grisha-gu/agentlight/docs/01-architecture.md

# 01. Architecture

## 1.1. Why a daemon

A stateless design — every hook is a short-lived process that recolours a lamp and
exits — is not enough here:

* the device has **4 independent slots**, and something has to remember which
  `session_id` lives in which slot;
* the **buttons must be read**, so something has to stay connected to the device;
* a light must **go dark when an agent dies** without sending `SessionEnd`;
* the USB device needs **a single owner** that handles hot-plug, reconnects and the
  heartbeat.

So the host side is a resident daemon, `agentlightd`, running as a LaunchAgent, plus
stateless hooks that only forward events to it.

## 1.2. Slot states

```
        SessionStart
   OFF ─────────────► WELCOME ──► IDLE (green)
    ▲                               │  ▲
    │                UserPromptSubmit│  │ Stop
    │ SessionEnd                     ▼  │ Notification(agent_completed)
    │ / watchdog                   BUSY (yellow)
    │                               │  ▲
    │          PermissionRequest    │  │ PreToolUse / PostToolUse
    │          Notification(...)    ▼  │ PermissionDenied
    └──────────────────────────── ATTN (red)
```

Four visible states plus one transient one:

| Code | Light | Meaning |
|---|---|---|
| `OFF` | dark | the slot is free, no agent |
| `WELCOME` | ~1.2 s animation | the slot has just been taken |
| `IDLE` | green | the agent is alive and waiting for your input |
| `BUSY` | yellow | the agent is thinking or running tools |
| `ATTN` | red | the agent is blocked and waiting for a decision |

## 1.3. Mapping Claude Code hooks to states

Every hook receives `session_id`, `transcript_path`, `cwd` and `hook_event_name`.
The full list of events and their fields: <https://code.claude.com/docs/en/hooks>.

| Hook | Matcher | Transition | Hook type |
|---|---|---|---|
| `SessionStart` | — | claim a slot → `WELCOME` → `IDLE` | **command** (needs the terminal's environment) |
| `UserPromptSubmit` | — | → `BUSY` | http |
| `PreToolUse` | — | → `BUSY` (keepalive) | http |
| `PostToolUse` | — | → `BUSY` (keepalive) | http |
| `PostToolUseFailure` | — | → `BUSY` | http |
| `PermissionRequest` | — | → `ATTN` | http |
| `PermissionDenied` | — | → `BUSY` | http |
| `Notification` | `permission_prompt` | → `ATTN` | http |
| `Notification` | `idle_prompt` | **ignored** (see below) | http |
| `Notification` | `agent_needs_input` | → `ATTN` | http |
| `Notification` | `elicitation_dialog`, `elicitation_url_dialog` | → `ATTN` | http |
| `Notification` | `agent_completed` | → `IDLE` | http |
| `Elicitation` | — | → `ATTN` | http |
| `Stop` | — | → `IDLE` | http |
| `StopFailure` | — | → `ATTN` (API error — a human is needed) | http |
| `SubagentStart` / `SubagentStop` | — | **no state change** (only extends the session's lifetime) | http |
| `PreCompact` / `PostCompact` | — | **no state change** | — |
| `SessionEnd` | — | release the slot → `OFF` | http |

### Why `idle_prompt` does not mean `ATTN`

`Notification(idle_prompt)` looks like "input required", but captured traffic shows
it is an **inactivity timer**: it fires exactly 60 seconds after the agent finishes
its turn.

```
17:34:19.679  Stop                        → IDLE (green)
17:35:19.695  Notification idle_prompt    exactly +60.0 s
              message: "Claude is waiting for your input"
```

It means the same thing as `Stop`: the agent is done and waiting for you. Mapping
it to `ATTN` would turn every idle agent red a minute after it answered, and red
would stop meaning "nothing happens without you".

**Rule: `ATTN` only when the agent is actually blocked on a decision** —
`PermissionRequest`, `Notification(permission_prompt)`,
`Notification(agent_needs_input)`, `Elicitation`, `StopFailure`.
`idle_prompt` does not change the state at all.

Self-healing sequences the state machine is tested against:

```
Pre(BUSY) → PermissionRequest(ATTN) → [user allows] → PostToolUse(BUSY) → Stop(IDLE)
Pre(BUSY) → PermissionRequest(ATTN) → [user denies] → PermissionDenied(BUSY) → Stop(IDLE)
Stop(IDLE) → Notification(idle_prompt, +60 s) (state does NOT change, stays IDLE)
```

### Why subagents do not turn the light yellow

Claude Code launches forked agents on its own while you are away: `away_summary`
(after ~3 minutes of inactivity), `prompt_suggestion`, `agent_summary`, and it may
compact the context while idle. If `SubagentStart`/`SubagentStop` mapped to `BUSY`,
an idle agent would turn yellow a few minutes after `Stop` and stay that way until
`busy_timeout_sec`. A real subagent runs inside a turn, when the slot is already
yellow from `UserPromptSubmit`/`PreToolUse`, so nothing is lost by ignoring them.

To debug cases like this, the daemon logs every hook (without prompts or tool
contents) to `~/.agentlight/hooks.jsonl`.

### `/clear` and `--resume`

`/clear` produces `SessionEnd(end_reason="clear")` followed by
`SessionStart(source="clear")` with a **new** `session_id`. Releasing the slot on
`SessionEnd` right away would make the light blink off and possibly move the agent
to another slot.

So on `SessionEnd` with `end_reason ∈ {clear, resume}` the slot is not released
but marked `rebinding` for 15 seconds, keyed by `(cwd, claude_pid)`. The next
`SessionStart` with the same key takes the same slot and does **not** play the
welcome animation.

## 1.4. Slot allocation

```
claim(session_id, cwd, pid):
  1. if session_id already has a slot → return it
  1a. if the claude process is a daemon spare or a parked tab → hidden "background" list
  1b. if it is a background session whose parked tab holds a slot → take that slot, no welcome
  2. if a slot is in `rebinding` with key (cwd, pid) → take it, no welcome
  3. if the config pins cwd (or a parent path) to a slot and that slot is free → take it
  4. otherwise → the lowest free index 0..slot_count-1
  5. if nothing is free → overflow queue (no light)
```

* **Background sessions** (`claude --bg`, a session sent to the background, a task
  dispatched from agent view) run under Claude Code's own daemon, in a pty that is
  not a terminal window. Their roles come from Claude Code's registry,
  `~/.claude/sessions/<pid>.json` (internal format, checked on 2.1.309–2.1.316):
  * `kind: "bg"` with a `jobId` is a background session; it gets a light like any
    other session.
  * `kind: "interactive"` with `parkedJobId` is a **parked tab**: its session was
    forked into job `parkedJobId`, and the process stays on as a viewer for agent view
    and attached sessions. Its own session gets no light; its slot passes to the
    session of that job, so the light the user associates with the tab stays put.
    `parkedJobId` does not change when the user switches sessions inside the tab, so
    what the tab shows right now is not knowable.
  * `spare: true` is the spare process the daemon pre-spawns for agent view's input
    box. It has no light until the user dispatches a task from agent view: then the
    flag disappears and the same process becomes an ordinary background session. An
    unclaimed spare has no registry file yet but already runs `SessionStart`; it is
    recognized by `--bg-spare` in its argv.

  Hidden sessions go to the `background` list (shown by `agentlight status`); their
  events are absorbed there, and the entry is dropped on `SessionEnd` or when the
  process dies. The registry is re-read on every hook and in the 5-second sweep, which
  moves sessions between slots and `background` both ways.
* **Cross-check against the public list.** The registry is an internal format and may
  change in any release, so every 30 seconds the daemon also runs `claude agents
  --json`, which the CLI documents for scripting. It lists exactly the real sessions
  (interactive, `-p`, background) and leaves out parked tabs and spares. Where both
  sources know a process and disagree, the public list wins, and the daemon logs a
  warning once (`agentlight doctor` runs the same check). The list is ignored for a
  process that started, or whose registry file changed, after the snapshot, and it
  only ever hides a process that has a registry file or `--bg-spare` in its argv.
  Without a recognizable registry, `--bg-spare` alone hides nothing, because a task
  dispatched from agent view keeps that argv. What cannot be recovered without the
  registry is the parked tab, so a forked session then takes a new slot instead of
  its tab's. `AGENTLIGHT_CLAUDE_SESSIONS=<dir>` points the host at another registry
  directory, which is how to rehearse a format change.
* **The focus button for a background session** resolves its tab at press time: a
  live `claude attach <id>` on that job, otherwise the parked tab it came from (most
  likely still showing it), otherwise a new Terminal window with `claude attach <id>`.
  A second `attach` only mirrors the session, it does not take it over.
* `release(slot)` happens on `SessionEnd`, on a liveness check (`kill(pid, 0)`
  every 5 s), or on a TTL (no events for 8 hours). The TTL only applies to sessions
  without a known PID, and time the Mac spends asleep does not count.
* **Esc** (interrupting a turn, dismissing a question or a permission prompt) sends
  no hook. The daemon tails the session transcript and treats the
  `[Request interrupted by user…]` line as → `IDLE`.
* When a slot is released, the occupied slots to its right shift left, so there are
  no gaps between lights (shifted slots do not replay the welcome animation; mute
  and `rebinding` move with the slot). The overflow session with the most recent
  event moves into the first free slot (and does get a welcome). Pins and the
  empty-slot button only affect where a session lands when it starts.
* The mapping is persisted in `~/.agentlight/state.json` (atomic write via a temp
  file + rename), so restarting the daemon keeps the assignments.

### Configuration

`~/.agentlight/config.json`:

```json
{
  "port": 48879,
  "brightness": 120,
  "slot_count": 4,
  "pins": {
    "/Users/me/projects/agentlight": 0,
    "/Users/me/work/backend": 1
  },
  "busy_timeout_sec": 900,
  "idle_pulse": false,
  "empty_slot_button_launches": "~/projects",
  "terminal_focus_order": ["tmux", "native", "new_window"],
  "menu_bar_icon": "auto"
}
```

`slot_count` is the number of lights in the app (1–16, default 4; also editable in
**Settings…**). One device shows 4 of them: the first connected device shows slots
0..3, the second 4..7, and so on ([§5.8](05-host-macos.md#58-usb-transport)). Slots
without a device are only visible in the menu bar. Lowering `slot_count` moves
sessions from the removed slots to overflow; raising it fills the new slots from
overflow.

`menu_bar_icon` is how the menu bar icon draws its lights (also in **Settings…**):
`auto` (default) puts each group of four on a dark rounded plate when the menu bar
shows black icons, `plain` never does, `plates` always does.

## 1.5. Two-level watchdog

| Level | Condition | Action |
|---|---|---|
| host → slot | no events in `BUSY` for `busy_timeout_sec` (900 s) | degrade to `IDLE` |
| host → slot | `kill(pid, 0)` fails | `release` → `OFF` |
| device → all slots | no `PING` from the host for > 3 s | turn every light off |

The last one keeps the lights honest: if the daemon crashes or the Mac goes to
sleep, the lights go dark on their own instead of showing a stale green.

## 1.6. Buttons

| Press | Slot occupied | Slot empty |
|---|---|---|
| short | focus the agent's terminal window | start a new `claude` in the directory from `empty_slot_button_launches` |

A button has exactly one action and reacts immediately — there are no long-press or
double-press gestures, so no press is delayed waiting for a second one. Muting a
slot is available as `agentlight mute <slot>`. Debouncing happens in the firmware;
the host receives a ready `!BTN <slot> press`.

## 1.7. Repository layout

```
agentlight/
├── firmware/              # RP2040 firmware, Pico SDK + TinyUSB, C
│   └── src/               # leds, anim, buttons, power, proto, transport_hid, usb_descriptors, …
├── host/                  # macOS app: Swift package
│   ├── Sources/
│   │   ├── AgentLightKit/ # slots, state machine, transports, hooks — no UI, unit-tested
│   │   ├── agentlightd/   # the daemon + menu bar UI
│   │   └── agentlight/    # CLI: install-hooks, status, doctor, …
│   ├── Tests/
│   └── scripts/           # build-app.sh (AgentLight.app), icon generator
├── hardware/pcb/          # KiCad board, generated by Python scripts; JLCPCB fab outputs
├── packaging/homebrew/    # Homebrew cask template
├── tools/
│   ├── proto_test.py      # firmware protocol test over CDC
│   ├── flash.sh           # build + flash without pressing BOOT
│   └── hook-capture/      # HTTP hook capture server + recorded samples (test fixture)
└── docs/
```
