grisha-gu/agentlight/hardware/pcb/agentlight.kicad_pcb

## KiCad design hardware/pcb/agentlight.kicad_pcb (2026-10-31)

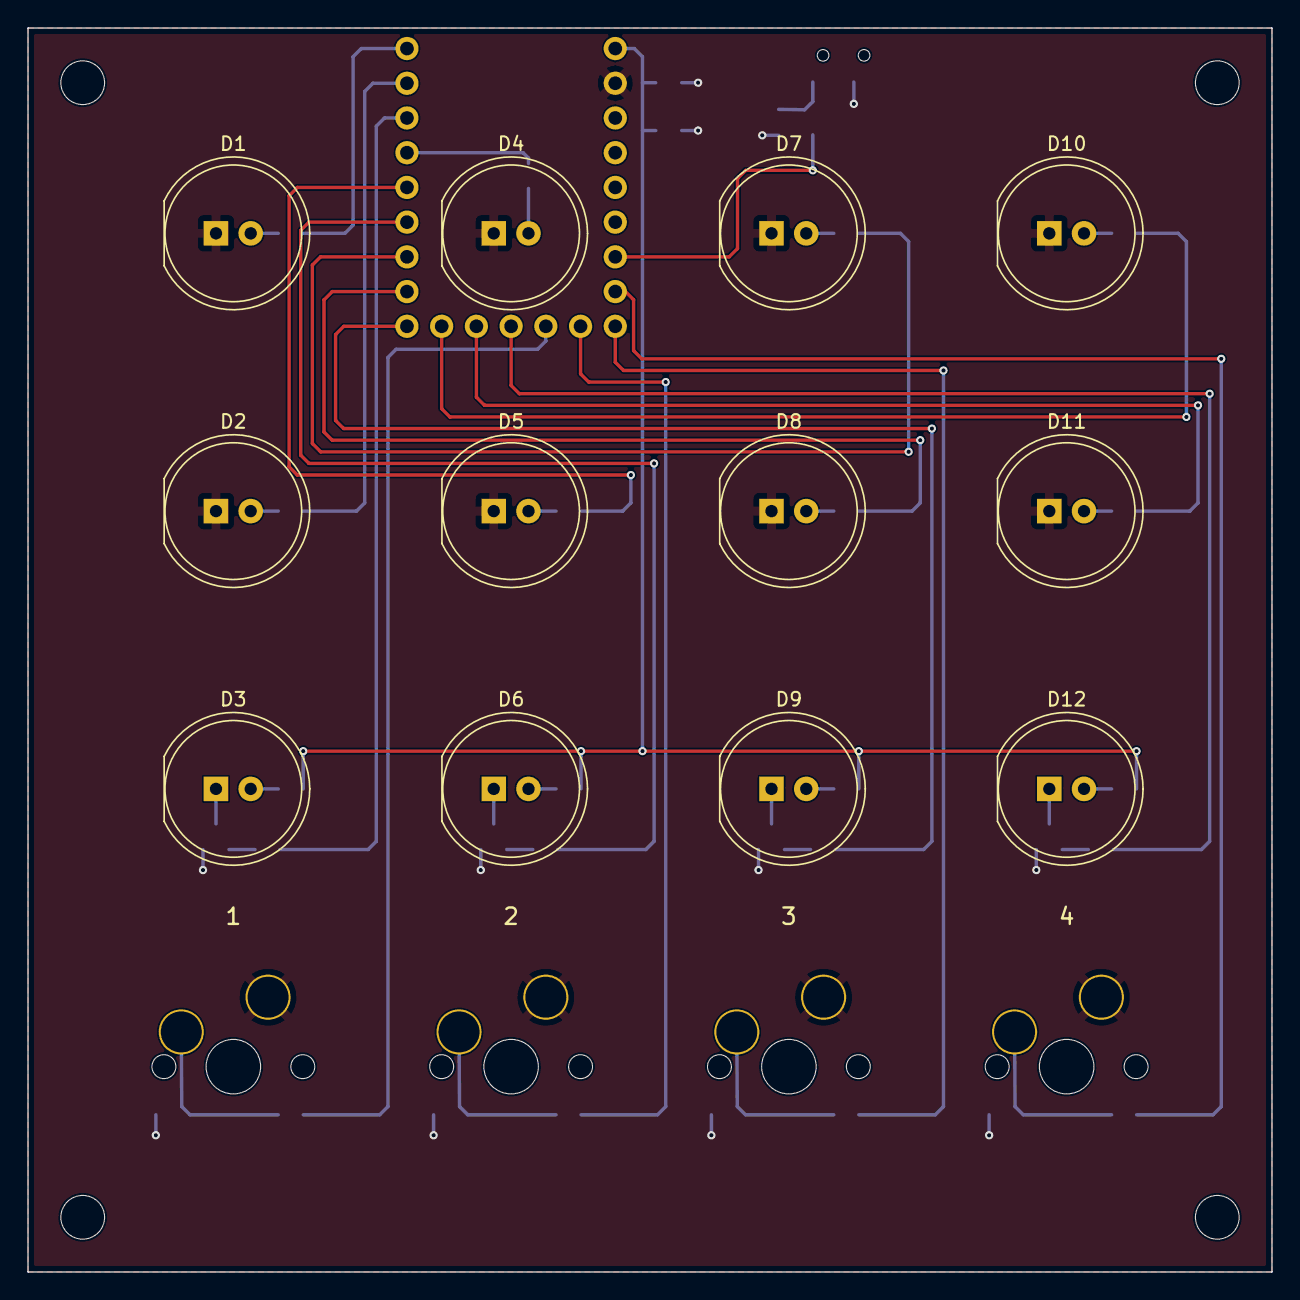
[picture p1: board agentlight.kicad_pcb from above]

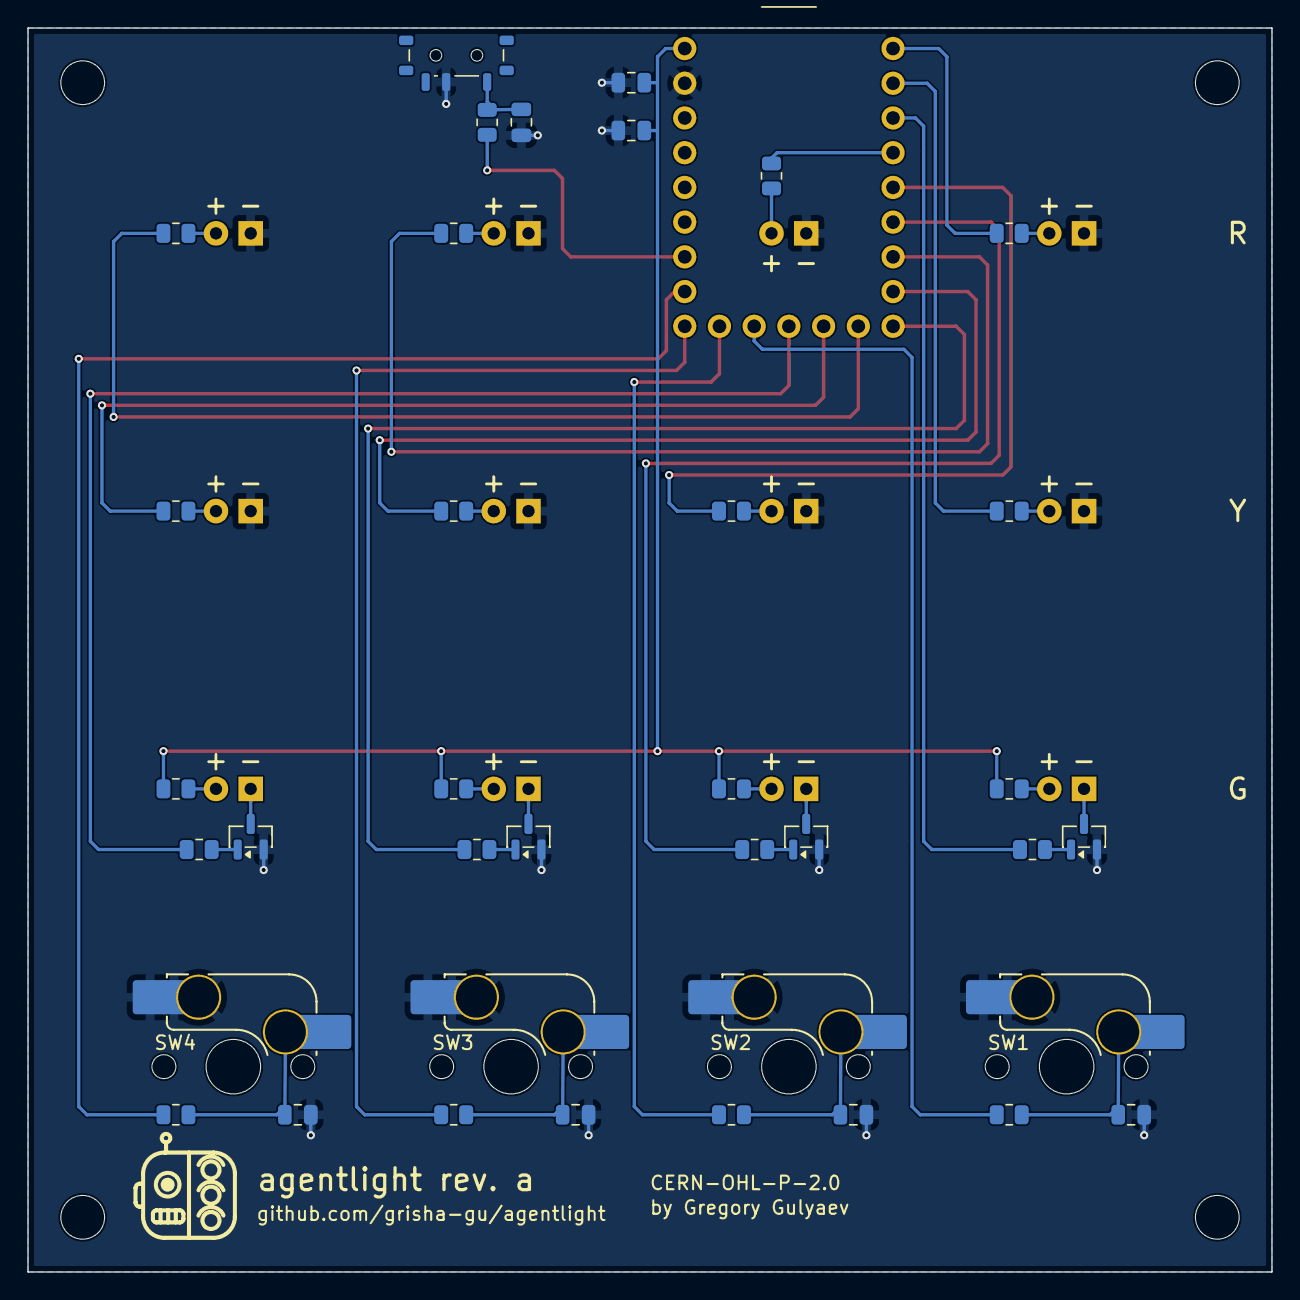
[picture p2: board agentlight.kicad_pcb from below]

Board: 2 copper layers, 91.0 x 91.0 mm, 57 parts (41 on the bottom side), 44 nets.

Parts:
C1, C2, C3, C4, C5, C7: 100n; C_0805_2012Metric
C6: 10u; C_0805_2012Metric
D1, D4, D7, D10: LED10_RED; LED_D10.0mm
D2, D5, D8, D11: LED10_YELLOW; LED_D10.0mm
D3, D6, D9, D12: LED10_GREEN; LED_D10.0mm
H1, H2, H3, H4: M3; MountingHole_3.2mm_M3
J1, J2: Socket_1x8; PinSocket_1x08_P2.54mm_Vertical
J3: Socket_1x7; PinSocket_1x07_P2.54mm_Vertical
Q1, Q2, Q3, Q4: S8050; SOT-23
R1, R2, R4, R5, R7, R8, R10, R11, R31, R32, R33, R34, R35: 220; R_0805_2012Metric
R3, R6, R9, R12: 330; R_0805_2012Metric
R21, R22, R23, R24: 1k; R_0805_2012Metric
SW1, SW2, SW3, SW4: MX_hotswap; SW_MX_HS_CPG151101S11_1u
SW5: MSK12C02; SW_SPDT_Shouhan_MSK12C02
U1: RP2040-Zero; RP2040-Zero_Outline

Connections:
+5V: C6.2, C7.2, J2.1, R3.1, R6.1, R9.1, R12.1
BTN0: C1.1, R31.2, SW1.1
BTN1: C2.1, R32.2, SW2.1
BTN2: C3.1, R33.2, SW3.1
BTN3: C4.1, R34.2, SW4.1
GND: C1.2, C2.2, C3.2, C4.2, C5.1, C6.1, C7.1, D1.1, D2.1, D4.1, D5.1, D7.1, D8.1, D10.1, D11.1, J2.2, Q1.2, Q2.2, Q3.2, Q4.2, SW1.2, SW2.2, SW3.2, SW4.2, SW5.2
GP0: J1.1, R1.1
GP1: J1.2, R2.1
GP2: J1.3, R21.1
GP3: J1.4, R4.2
GP4: J1.5, R5.1
GP5: J1.6, R22.1
GP6: J1.7, R7.1
GP7: J1.8, R8.1
GP8: J3.1, R23.1
GP9: J3.2, R10.1
GP10: J3.3, R11.1
GP11: J3.4, R24.1
GP12: J3.5, R31.1
GP13: J3.6, R32.1
GP14: J3.7, R33.1
GP15: J2.8, R34.1
GP26: J2.7, R35.1
LED0_A: D1.2, R1.2
LED1_A: D2.2, R2.2
LED2_A: D3.2, R3.2
LED2_K: D3.1, Q1.3
LED3_A: D4.2, R4.1
LED4_A: D5.2, R5.2
LED5_A: D6.2, R6.2
LED5_K: D6.1, Q2.3
LED6_A: D7.2, R7.2
LED7_A: D8.2, R8.2
LED8_A: D9.2, R9.2
LED8_K: D9.1, Q3.3
LED9_A: D10.2, R10.2
LED10_A: D11.2, R11.2
LED11_A: D12.2, R12.2
LED11_K: D12.1, Q4.3
PWR_SW: C5.2, R35.2, SW5.1
Q0_B: Q1.1, R21.2
Q1_B: Q2.1, R22.2
Q2_B: Q3.1, R23.2
Q3_B: Q4.1, R24.2
