grisha-gu/agentlight/(commit log)

2026-10-31 Initial import: host app, firmware, PCB rev. a, docs
    State as of PCB rev. a ordered from JLCPCB (2026-10-31): macOS daemon and
    CLI (host/), RP2040 firmware 0.6.0 (firmware/), board generated by
    hardware/pcb/gen_board.py, design docs (docs/).
    Licenses: code MIT, hardware CERN-OHL-P-2.0, docs CC-BY-4.0.
    [agentlight.kicad_pcb]
2026-11-02 Host 0.2.0: bundle id dev.grisha-gu.agentlight, doctor checks Automation, wake fix
    - Bundle id com.agentlight.app → dev.grisha-gu.agentlight, LaunchAgent label
    dev.grisha-gu.agentlight.daemon; install-daemon removes the legacy agent,
    build-app.sh --install migrates automatically.
    - doctor reports Automation → Terminal: the daemon asks TCC without a prompt
    (AEDeterminePermissionToAutomateTarget) and returns it in /status.
    - Sleep: after DarkWake → FullWake macOS posts no didWake, so the daemon stayed
    paused and sent nothing to the device. Also resume on screensDidWake; keep the
    earliest sleep time across consecutive willSleep.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
    [proto_test.py]
2026-11-02 Background sessions: hide windowless ones, light up forks in their owner tab
    Sessions hosted by the Claude Code daemon (claude --bg, forks sent to the
    background) run under bg-pty-host. The daemon also pre-spawns a --bg-spare
    process that fires SessionStart with no user behind it and sat on a light
    as a permanently idle agent.
    A fork is watched from the tab that started the daemon: the daemon's argv
    carries `--spawned-by {"pid":N}`. While claude process N is alive and has
    a tty, the session gets its own slot, the hook reports N's terminal (tty
    and env read via KERN_PROCARGS2), and the focus button resolves the owner
    tab at press time for sessions that started earlier.
    --bg-spare and forks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
2026-11-02 Docs in English; move internal dev notes out of git
    - Rewrite README and docs/01–05 in English, describing the current device
    (section numbers kept for code references); new docs/06-assembly.md for PCB rev. a
    - Translate host, hardware/pcb and hook-capture READMEs
    - Build plan and breadboard assembly log move to notes/ (gitignored)
    - Redact Russian strings from the hook capture fixture
    - Update §2.x references in code comments
    [config.h, gen_board.py, power.h]
2026-11-02 Background sessions from Claude Code's registry: parked tabs, agent view, attach
    Session roles now come from ~/.claude/sessions/<pid>.json instead of argv and
    the daemon's --spawned-by (which tied every background session to whichever tab
    happened to start Claude Code's daemon):
    - interactive + parkedJobId is a parked tab: its session was forked into a
    background job and the process stays on as a viewer. Its own session no
    longer sits on a light as a permanently idle agent; its slot passes to the
    job's session, keeping the tab's mute.
    - spare: true is the process agent view claims for its input box; it stays
    hidden until a task is dispatched from agent view, then the flag disappears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
2026-11-03 Translate code to English; localize the menu bar UI (en + ru)
    All comments, logs, CLI output, scripts and tests are now in English.
    The menu bar UI uses standard macOS localization: English strings in the
    code are the keys, Russian lives in host/Resources/ru.lproj, and the app
    follows the system language (or the per-app override in System Settings).
    DeviceLink exposes a structured `status`; `statusText` stays English for
    /status and the CLI, the panel localizes `status` itself. agentlightd
    accepts `-AppleLanguages "(xx)"` so `--snapshot` can render any language.
2026-11-10 Menu bar icon: a high-contrast palette for the light menu bar
    When the menu bar switches to black icons, the lit lights get deeper colors
    and a dark ring and the unlit ones get fainter; the icon redraws on every
    appearance flip. --snapshot writes the icon for both looks.
2026-11-12 Menu bar icon: a dark rounded plate per group on the light menu bar
    Replaces the ring around lit lights: each group of four (or the leftover
    tail) sits on a dark rounded plate and keeps the bright colors.
2026-11-12 Settings: menu bar icon style (auto / plain / plates) and the app version
    menu_bar_icon in config.json, a segmented picker in Settings; auto keeps the
    plates for a light menu bar only. The version sits at the bottom of the window.
2026-11-12 Menu bar icon: one geometry for both styles, plates concentric with the lights
    Switching styles no longer resizes or moves the lights; a plate reaches 1 pt past
    its lights with a corner radius of d/2 + 1, so its corners follow the circles.
2026-11-12 Menu bar icon: slightly tighter plate corners (2.6 pt)
2026-11-12 Menu bar icon: plate corners 2.3 pt
2026-11-12 Menu bar icon: 1.5 pt plate margin, 19 pt tall
    Keeps the 4.5 pt lights; the plate radius follows (2.8 pt).
