grisha-gu/agentlight/(notices)

Notices in the files:
parts and their libraries:
Footprint for Cherry MX style switches with Kailh hotswap socket. From ebastler/marbastlib (CERN-OHL-P-2.0). Drawn mirrored: place flipped on B.Cu
